jtdreisb/articulate/README.md

Articulate
===========

A Capstone project for CPE350 for Cal Poly

Contributors
-----------
- Jason Dreisbach
- Anthony Lipscomb
- Anjelica Concepcion
- Norman Tran
- Michael Crivello
