jtdreisb/articulate/(commit log)

2012-10-25 Add Senior Project Write up by Paul Case
    Remove the executable files
2012-11-07 Add Glove in ArduinoSoft
    GUI still needs a lot of work
    Stay tuned for updates
2013-02-14 add samples directory
2013-02-21 remove sampled files from repository
2013-02-21 update the accelerometer filter
2013-03-04 add output library found online
    http://puredata.hurleur.com/sujet-1982-diy2-effects-sample-players-synth
    s-sound-synthesis
2013-03-09 added current sketch and device libraries
