jtdreisb/articulate/(notices)

Notices in the files:
Audio/attic/examples/ao_test/main.c:
Legal Terms:
This source file is released into the public domain. It is
